Makers-MakeitModena/Progetto_Lampada_V1_0/Hardware/Schema Elettrico.jpg

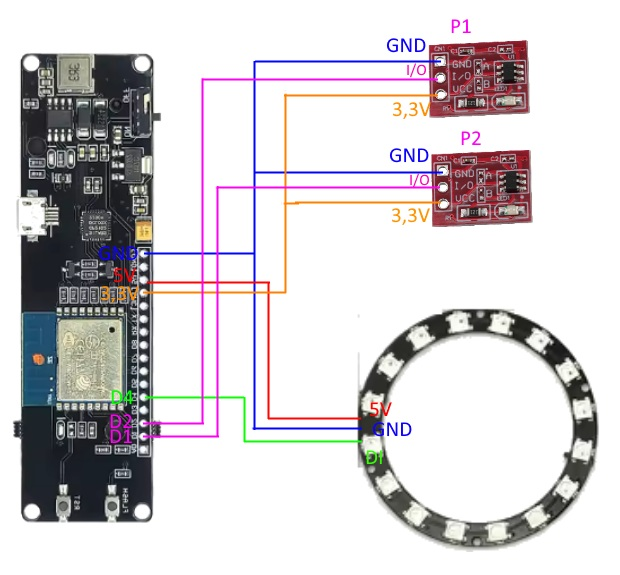
Hardware/Schema Elettrico.jpg
