Makers-MakeitModena/Progetto_Lampada_V1_0/Hardware/Pulsante Touch.png

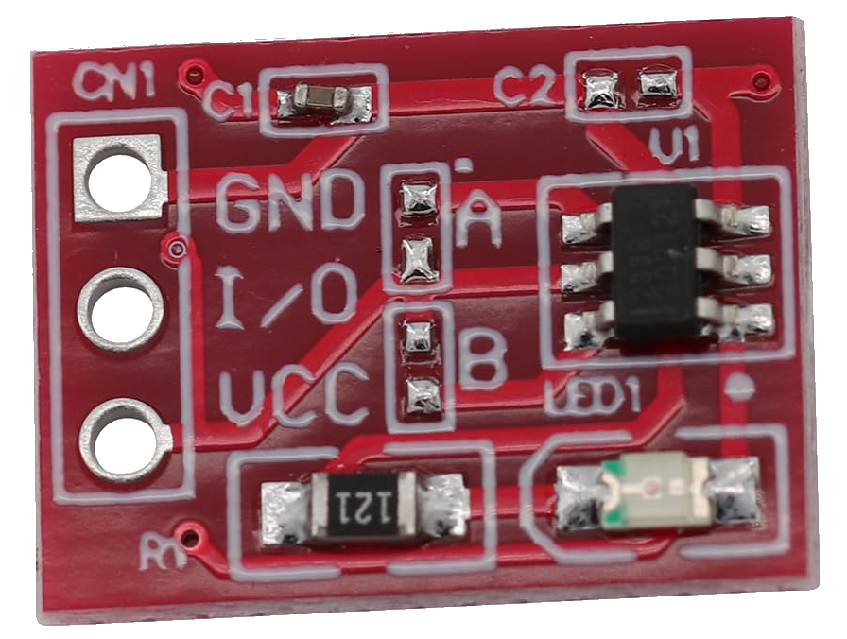
Hardware/Pulsante Touch.png
