Makers-MakeitModena/Progetto_Lampada_V1_0/README.md

# Progetto_Lampada_V1_0
Progettata e realizzata nel 2025-2026, questa lampada modulare realizzata con arduino, un anello di LED, e sensori touch capacitivi, è completamente personalizzabile.
