Makers-MakeitModena/Progetto_Lampada_V1_0/Hardware/Hardware.md

# Lista dei componenti hardware

- Scheda di controllo
<br>LOLIN(WEMOS) D1 ESP-WROOM-02
<br>Code name: ESP8266_WEMOS_D1WROOM02
<br>Attenzione: D1 ESP-WROOM-ESP32 ha la porta USB in posizione differente rispetto al modello necessario per il progetto CAD proposto nel progetto

- RGB LED
<br>Anello da 16 LED con controllore WS2812 5050
<br>Tipo Neowise Neopixel
<br>Diametro esterno 68 mm, interno 54 mm

- 2x TTP223 pulsante capacitivo piatto 15x11 mm

- Batteria ricabile 18650
4200 mAh, 3.7 V, ioni di Li
  
- Cavi e viti secondo le necessità come da schema elettrico
