Makers-MakeitModena/Progetto_Lampada_V1_0/Stampa_3D/Note di stampa.md

# Note per la stampa 3D

## Parti da stampare
- Scatola principlae
- Coperchio inferiore (avvitato sulla scatola)
- Anello per alloggire LED (avvitato sulla scatola)
- Perno a T di fissaggio (da incollare sulla scatola principale)
- Elemento decorativo superiore (ad esempio albero di Natale)

## Parametri di stampa
- Materiale per scatola, coperchio, perno a T ed anello: PLA
- Stampare la scatola appoggiando la parte superiore sul piatto di stampa
- Materiale per l'elemento decorativo: PLA trasparente

## Incollaggio del perno a T di fissaggio
- l'asse maggiore del perno va incollato ortogonalmente al lato in cui sono presenti i pulsanti touch
- una colla molto efficace è Kraftprotz Supercola XXl per PLA (cianoacrilato)
