Makers-MakeitModena/Progetto_Lampada_V1_0/Foto Lampada/Albero blu.jpeg

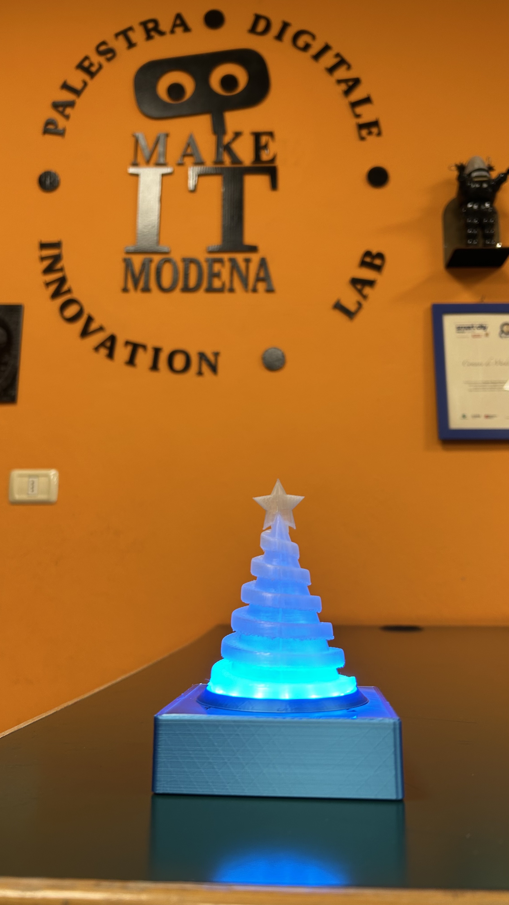
Foto Lampada/Albero blu.jpeg
