Makers-MakeitModena/Progetto_Lampada_V1_0/Foto Lampada/Albero rosa.jpeg

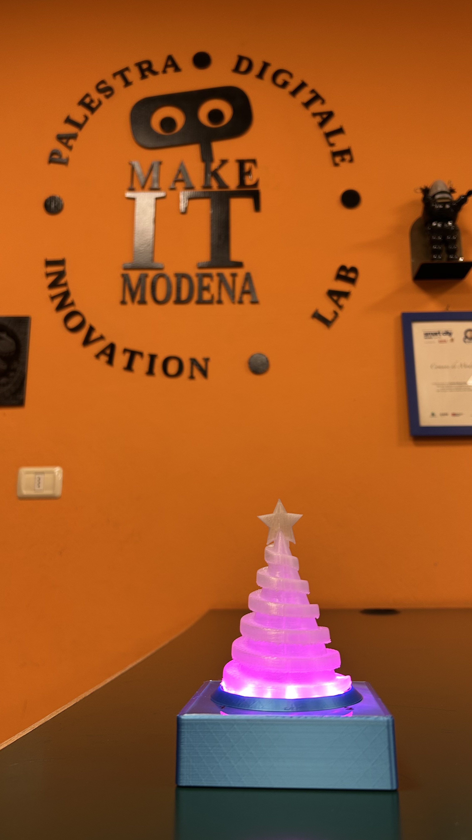
Foto Lampada/Albero rosa.jpeg
