Makers-MakeitModena/Progetto_Lampada_V1_0/Foto Lampada/Interno.jpeg

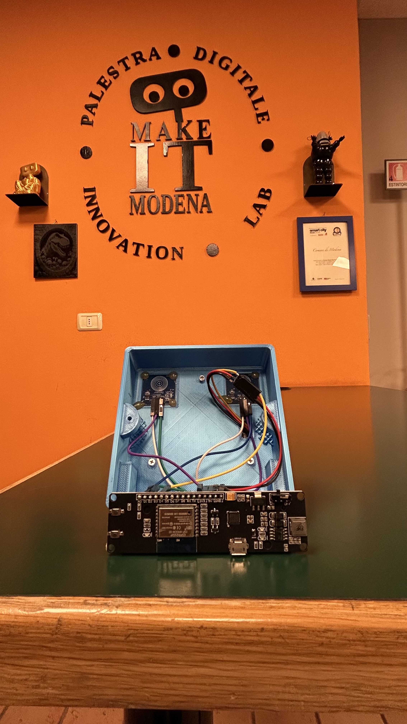
Foto Lampada/Interno.jpeg
