Makers-MakeitModena/Progetto_Lampada_V1_0/Foto Lampada/Lampada montata con albero di Natale.jpeg

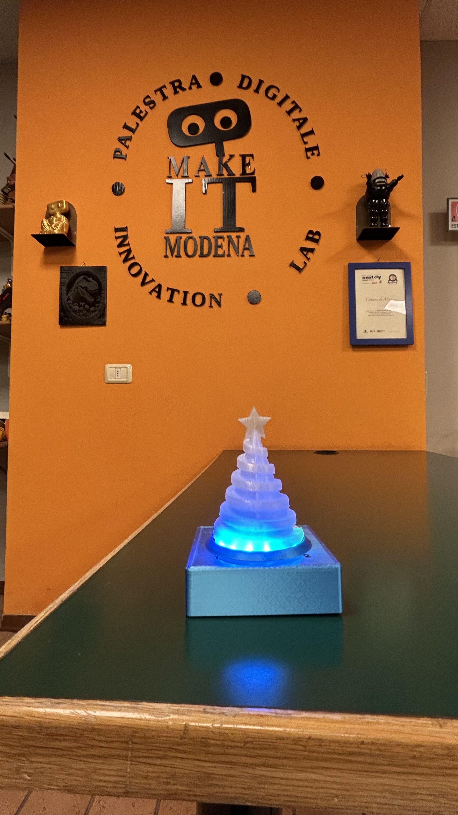
Foto Lampada/Lampada montata con albero di Natale.jpeg
