Makers-MakeitModena/Progetto_Lampada_V1_0/Foto Lampada/Scatola vista dall'alto con perno a T.jpeg

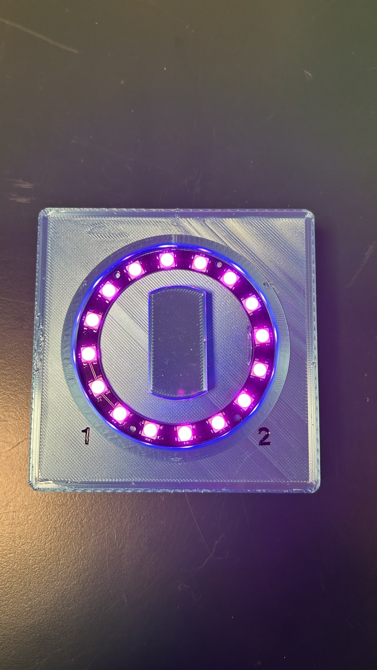
Foto Lampada/Scatola vista dall'alto con perno a T.jpeg
