Makers-MakeitModena/Progetto_Lampada_V1_0/Stampa_3D/coperchio scatola.step

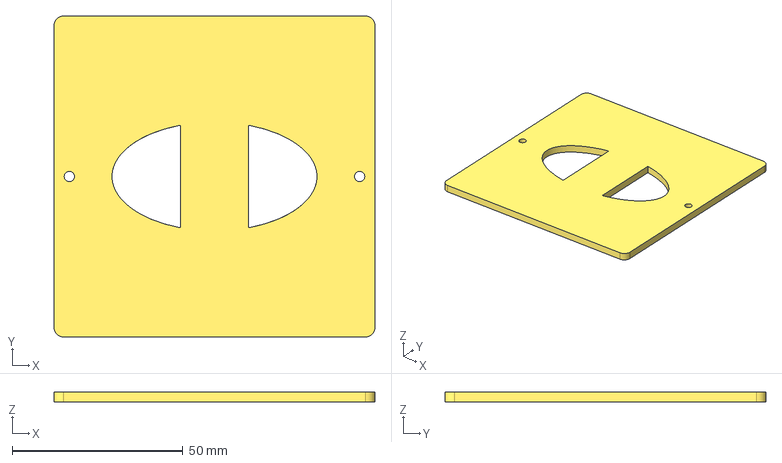
[picture p8: CAD file, 2026-01-21]
Stampa_3D/coperchio scatola.step
94.0 x 94.0 x 2.98 mm
