Makers-MakeitModena/Progetto_Lampada_V1_0/Stampa_3D/innesto femmina decoro.step

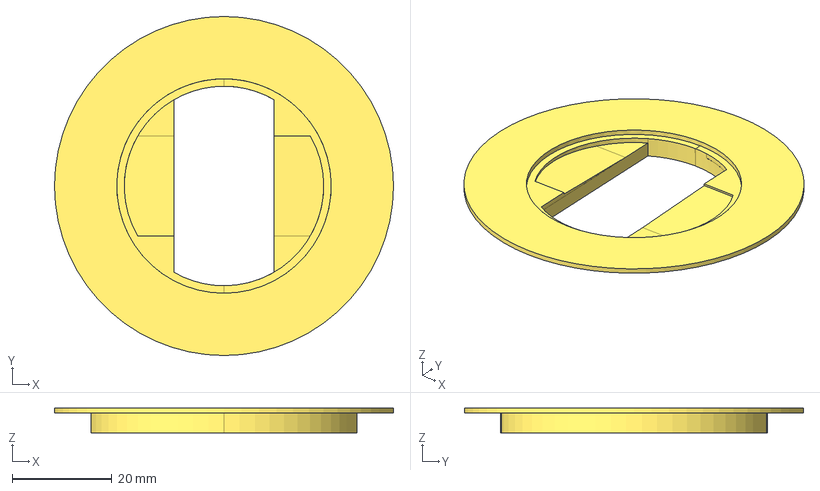
[picture p9: CAD file, 2026-01-21]
Stampa_3D/innesto femmina decoro.step
68.0 x 68.0 x 5.00 mm
