Makers-MakeitModena/Progetto_Lampada_V1_0/Stampa_3D/anello esterno.step

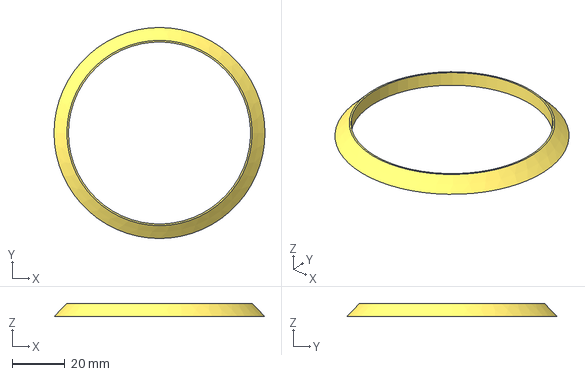
[picture p10: CAD file, 2026-01-21]
Stampa_3D/anello esterno.step
80.0 x 80.0 x 5.00 mm
