Makers-MakeitModena/Progetto_Lampada_V1_0/Stampa_3D/innesto.step

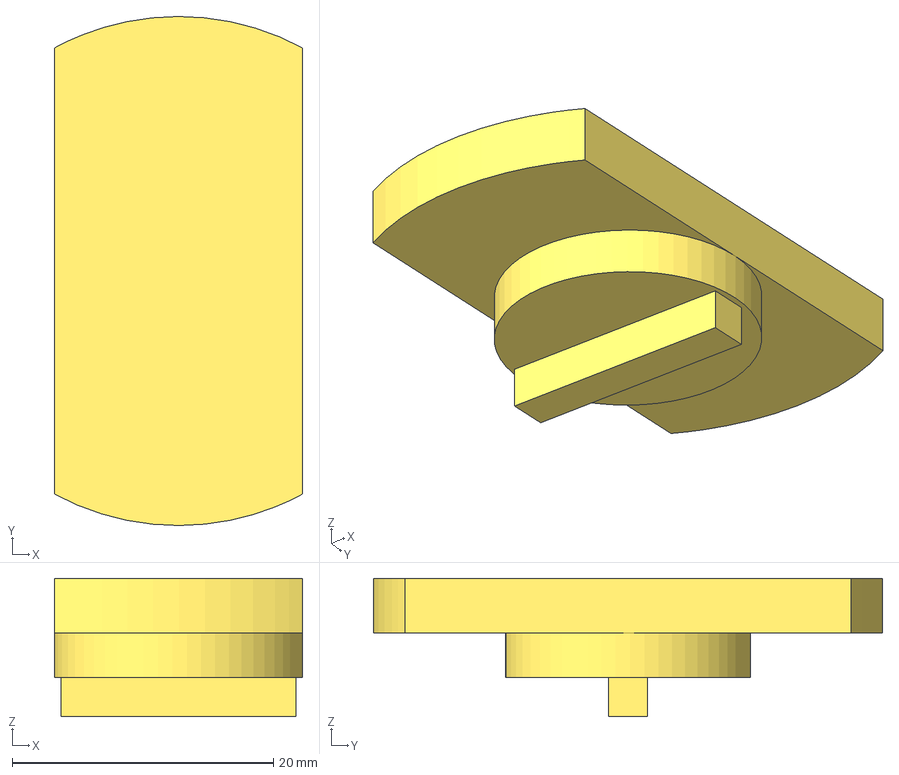
[picture p11: CAD file, 2026-01-21]
Stampa_3D/innesto.step
19.0 x 39.0 x 10.6 mm
