Makers-MakeitModena/Progetto_Lampada_V1_0/Stampa_3D/anello interno.step

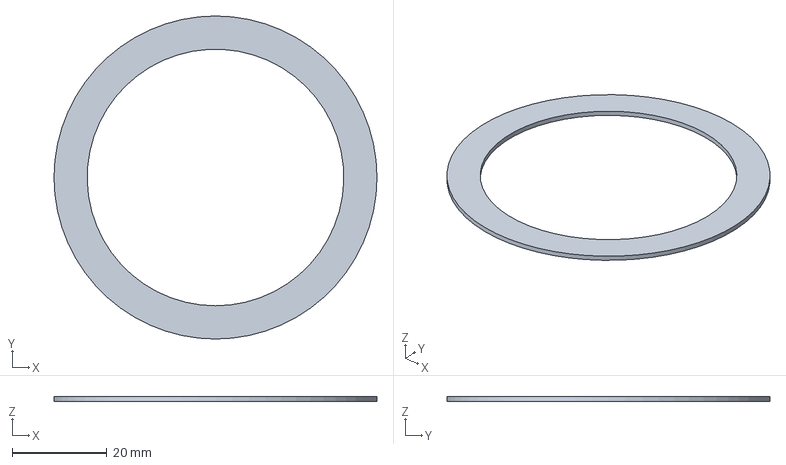
[picture p12: CAD file, 2026-01-21]
Stampa_3D/anello interno.step
68.0 x 68.0 x 1.00 mm
