Makers-MakeitModena/Progetto_Lampada_V1_0/(list of files, cad)

Other CAD files:
Stampa_3D/Lampada_v1b.f3d
