Makers-MakeitModena/Progetto_Lampada_V1_0/(commit log)

2026-01-07 Rename Lampada montata con labero di Natale.jpeg to Lampada montata con albero di Natale.jpeg
2026-01-07 Create Note di stampa.md
2026-01-14 Update Note di stampa.md
